Multi-Sensory-Devices/8x8-Wireless-Array/PCB Files/Ryuji_Controller/Resources/FPGA Dimensions.png

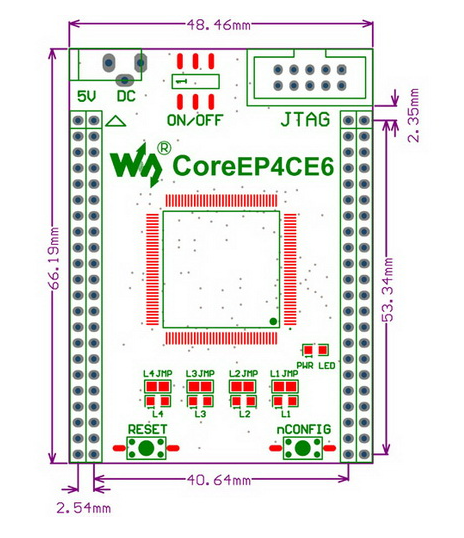
PCB Files/Ryuji_Controller/Resources/FPGA Dimensions.png
