Multi-Sensory-Devices/8x8-Wireless-Array/WiFi Code/first port to framework/README.md

# OpenMPD_Driver
OpenMPD is a low-level presentation engine allowing structured exploitation of any combination of MPD content (i.e., visual, tactile, audio) while dealing with the challenges specific to MPD content presentation.

For instance, our multi-rate runtime cycle allows us to combine very high computation rates for the sound-field (i.e., 10K sound-fields per second, for optimum acoustic control), with lower rates for control and rendering processes (i.e., hundreds of Hz, as typically used by rendering engines or tracking devices supporting interaction). Our low-level synchronization allows us to retain accurate interoperation among these processes, All of these enable novel capabilities, such as enabling colour projection onto high-speed particles or swept displays, as well as dexterous manipulations, such as in PoV content changing shape or precise combinations with other PoV paths. 

## OpenMPD Main Repository
[Main](https://github.com/RobertoMontano/OpenMPD)

## OpenMPD Libraries
[Libs](https://github.com/RobertoMontano/OpenMPD_Libs)

## OpenMPD Solver
[Solver](https://github.com/RobertoMontano/OpenMPD_Solvers)

## OpenMPD Installation Guide
[Setup](https://github.com/RobertoMontano/OpenMPD/blob/main/Docs/OpenMPD_FrameworkSetup.pdf)

## OpenMPD Framework Guide
[Guide](https://github.com/RobertoMontano/OpenMPD/blob/main/Docs/OpenMPD%20Tutorials_Guide.pdf)

## OpenMPD Examples Guide
[Examples](https://github.com/RobertoMontano/OpenMPD/blob/main/Docs/OpenMPD%20Tutorials_Examples.pdf)

## License
[MIT](https://choosealicense.com/licenses/mit/)
