Multi-Sensory-Devices/8x8-Wireless-Array/2D Drawings/ArrayBoardDimensions.png

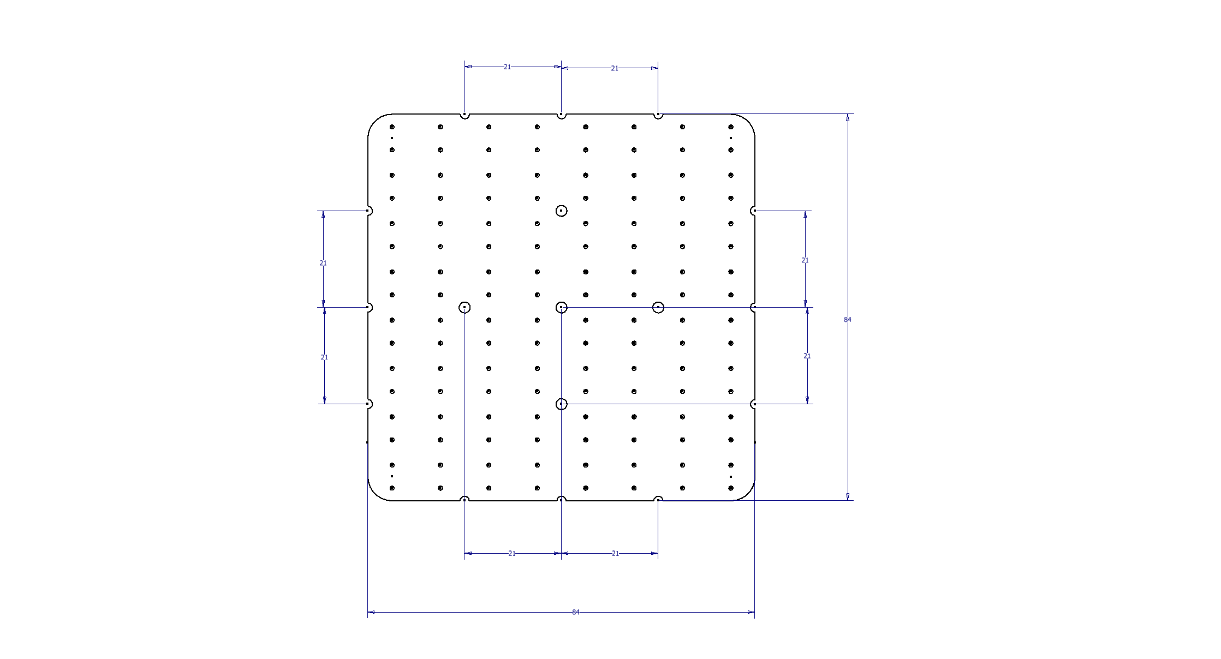
2D Drawings/ArrayBoardDimensions.png
