Multi-Sensory-Devices/8x8-Wireless-Array/2D Drawings/Controller_Ryuji.png

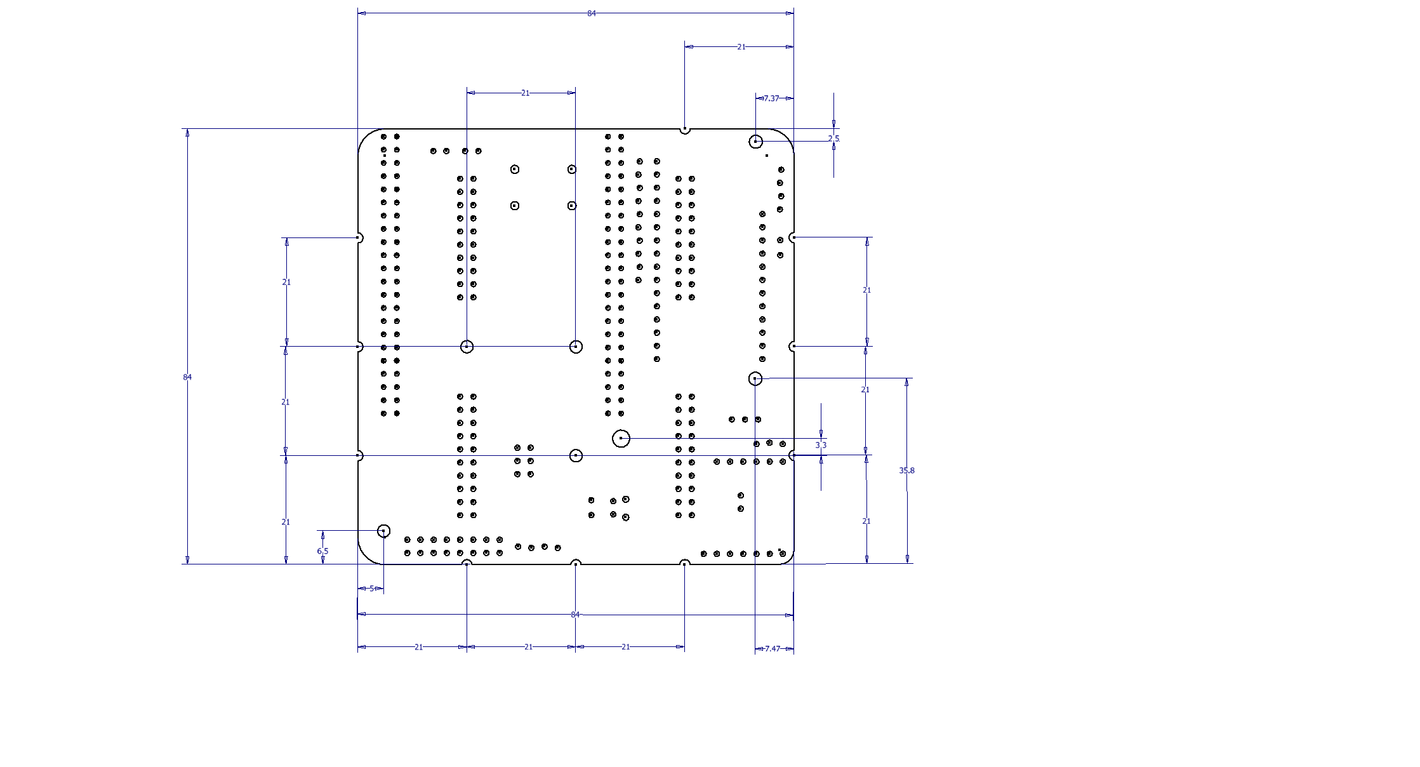
2D Drawings/Controller_Ryuji.png
