Multi-Sensory-Devices/8x8-Wireless-Array/PCB Files/Ryuji_Controller/Resources/circuitpython_Adafruit_Feather_nRF52840_Pinout.png

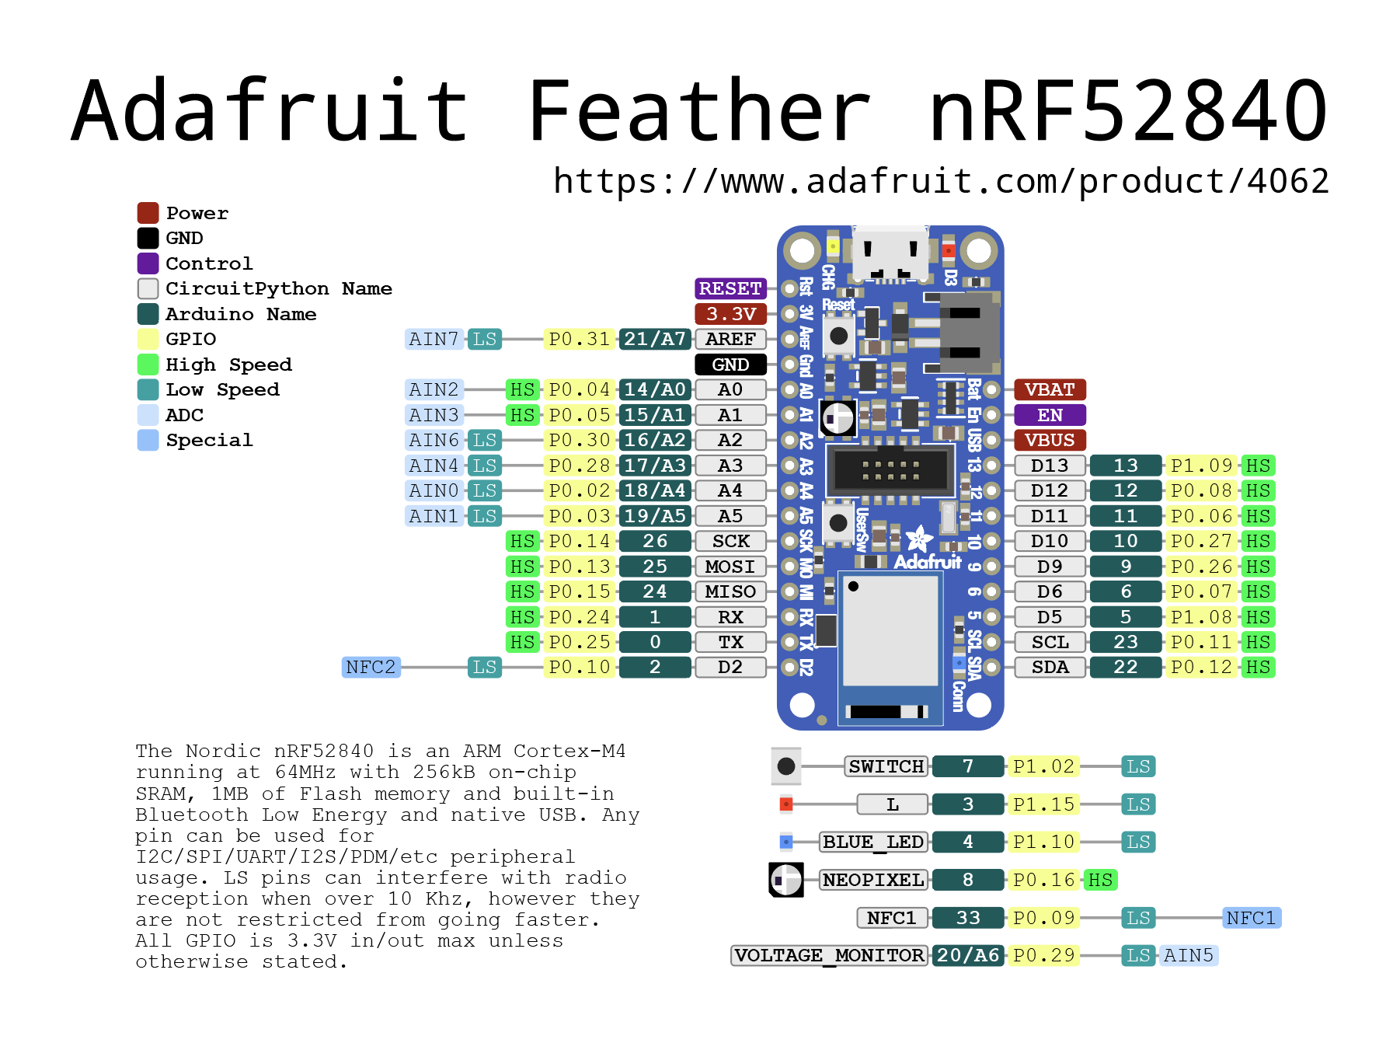
PCB Files/Ryuji_Controller/Resources/circuitpython_Adafruit_Feather_nRF52840_Pinout.png
