Multi-Sensory-Devices/8x8-Wireless-Array/2D Drawings/ArrayDimensions.dxf

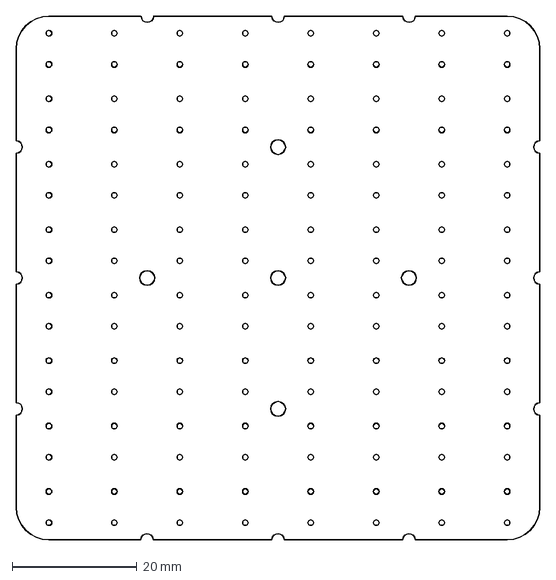
[picture p39: CAD file, 2023-06-09]
2D Drawings/ArrayDimensions.dxf
84.0 x 84.0 mm
