Multi-Sensory-Devices/8x8-Wireless-Array/3D Models/Jig/JigPrusa.3mf

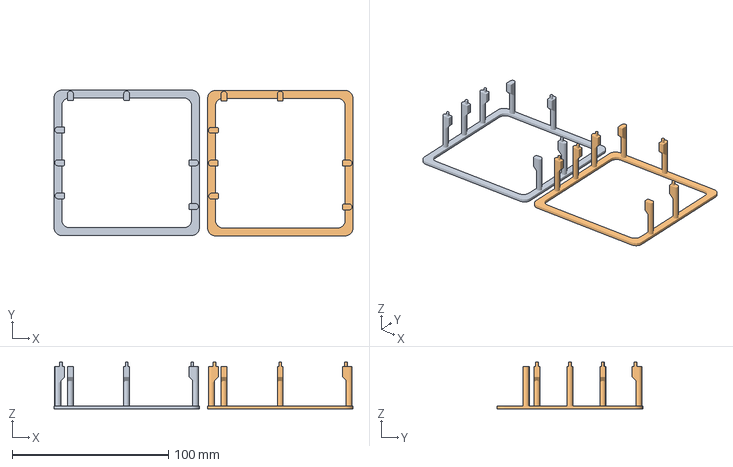
[picture p40: CAD file, 2023-06-09]
3D Models/Jig/JigPrusa.3mf
191.3 x 93.2 x 30.0 mm
