Multi-Sensory-Devices/8x8-Wireless-Array/PCB Files/Ryuji_8x8/Resources/B27c-2x10-BSAB1-G--3DModel-STEP-468060.STEP

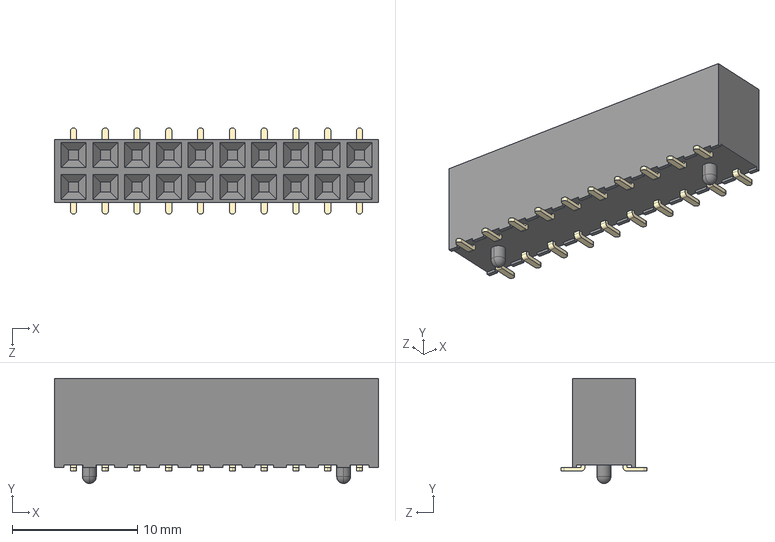
[picture p41: CAD file, 2023-06-09]
PCB Files/Ryuji_8x8/Resources/B27c-2x10-BSAB1-G--3DModel-STEP-468060.STEP
25.9 x 8.40 x 6.90 mm
