Multi-Sensory-Devices/8x8-Wireless-Array/2D Drawings/Controller Board Dimensions.dxf

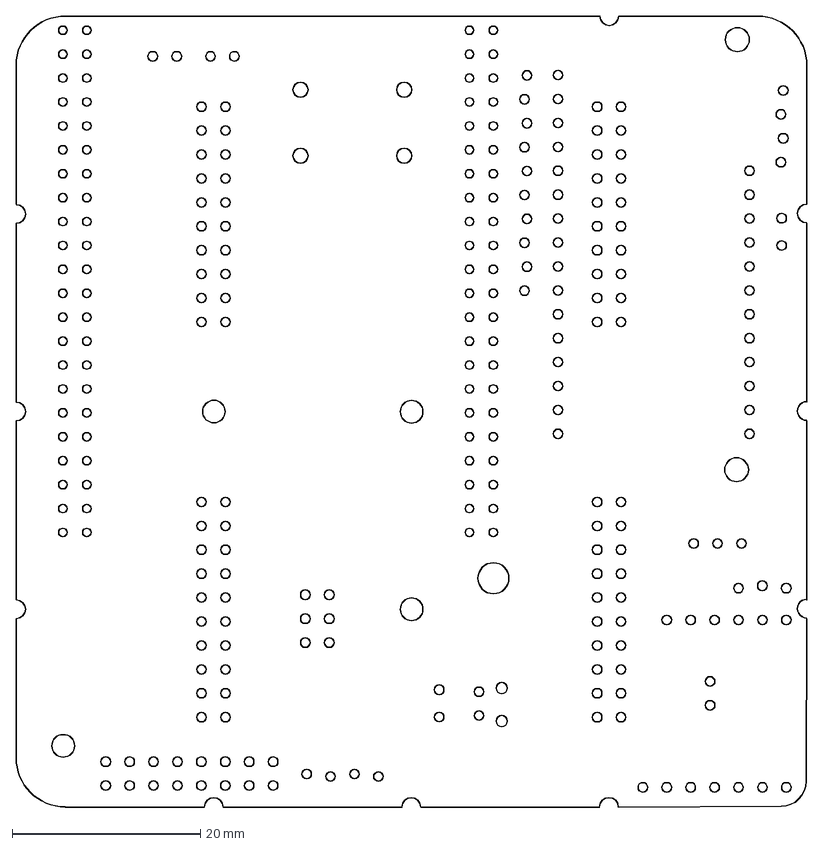
[picture p43: CAD file, 2023-06-09]
2D Drawings/Controller Board Dimensions.dxf
84.1 x 84.1 mm
