Multi-Sensory-Devices/8x8-Wireless-Array/3D Models/Jig/Jig.stp

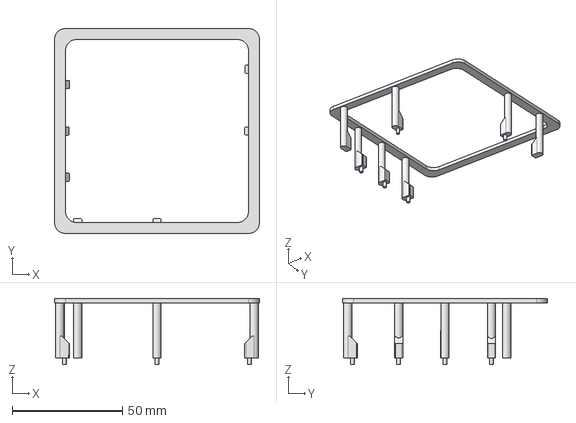
[picture p44: CAD file, 2023-06-09]
3D Models/Jig/Jig.stp
93.0 x 93.0 x 30.0 mm
