Multi-Sensory-Devices/8x8-Wireless-Array/PCB Files/Ryuji_8x8/Resources/TSSH-110-01-L-D.stp

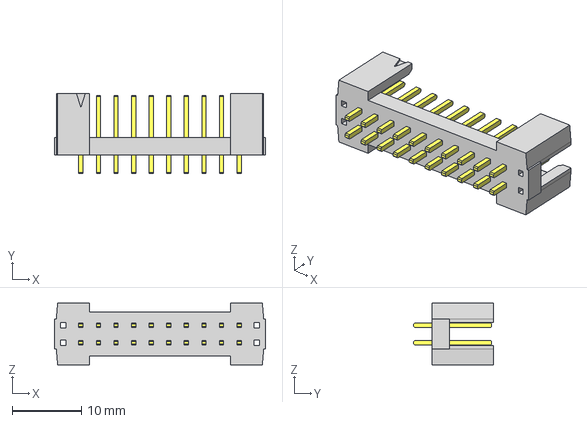
[picture p45: CAD file, 2023-06-09]
PCB Files/Ryuji_8x8/Resources/TSSH-110-01-L-D.stp
30.5 x 11.6 x 8.89 mm
T-1S6-10-01-D-
TSSH-110-01-D_header
