Multi-Sensory-Devices/8x8-Wireless-Array/PCB Files/Ryuji_Controller/Resources/PHT-103-01-S-S.stp

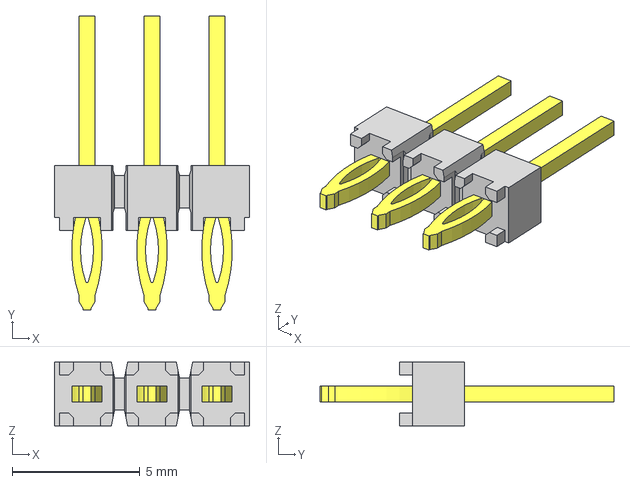
[picture p46: CAD file, 2023-06-09]
PCB Files/Ryuji_Controller/Resources/PHT-103-01-S-S.stp
7.62 x 11.5 x 2.49 mm
PHT-103-01-S_Pin
PHT-103-01-S_terminal
