Multi-Sensory-Devices/8x8-Wireless-Array/PCB Files/Ryuji_Controller/Resources/PHF-102-01-S-S.stp

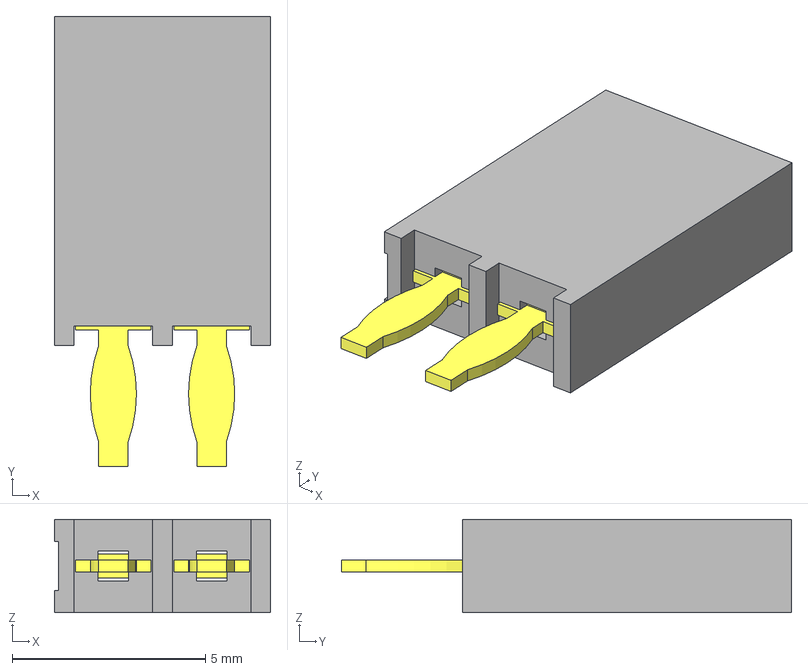
[picture p47: CAD file, 2023-06-09]
PCB Files/Ryuji_Controller/Resources/PHF-102-01-S-S.stp
5.59 x 11.6 x 2.41 mm
PHF102-01-S-S_pins
PHF102-01-S-S_terminal
