Multi-Sensory-Devices/8x8-Wireless-Array/PCB Files/Ryuji_8x8/Resources/SSW-110-22-G-D-VS.stp

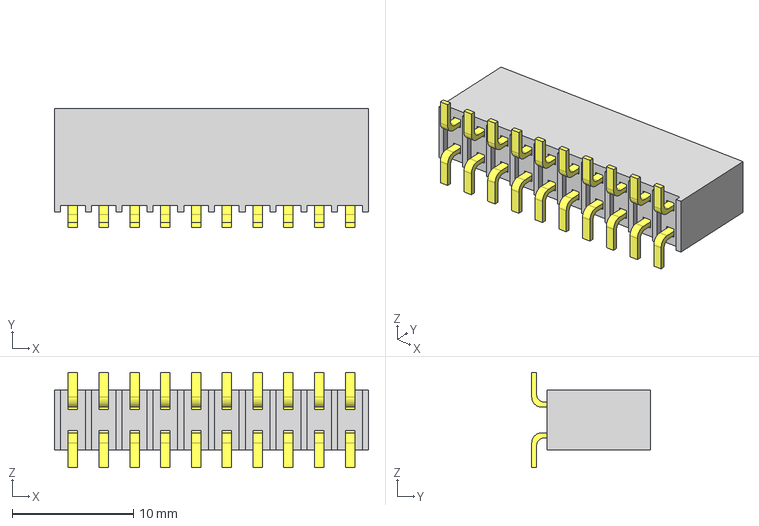
[picture p48: CAD file, 2023-06-09]
PCB Files/Ryuji_8x8/Resources/SSW-110-22-G-D-VS.stp
25.9 x 9.78 x 7.87 mm
P2SSW-110-22-G-D-VS
T1SSW-110-22-G-D-VS
