Multi-Sensory-Devices/8x8-Wireless-Array/PCB Files/Ryuji_Controller/Resources/PHF-116-01-S-S.stp

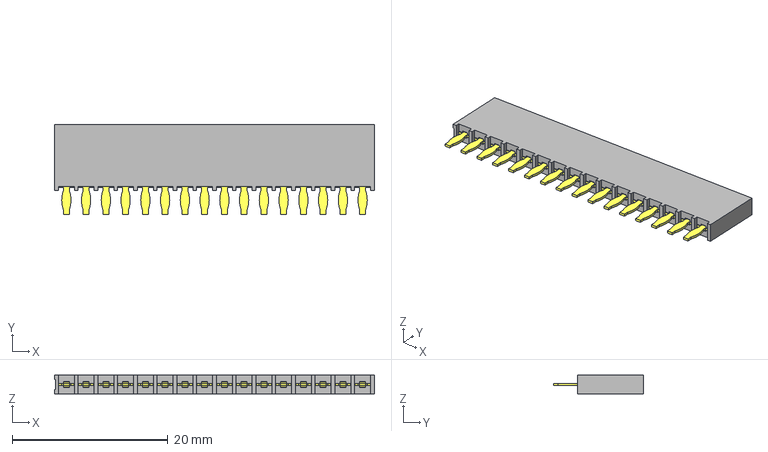
[picture p49: CAD file, 2023-06-09]
PCB Files/Ryuji_Controller/Resources/PHF-116-01-S-S.stp
41.1 x 11.6 x 2.41 mm
PHF116-01-S-S_pins
PHF116-01-S-S_terminal
