Multi-Sensory-Devices/8x8-Wireless-Array/PCB Files/Ryuji_Controller/Resources/PHF-104-01-S-S.stp

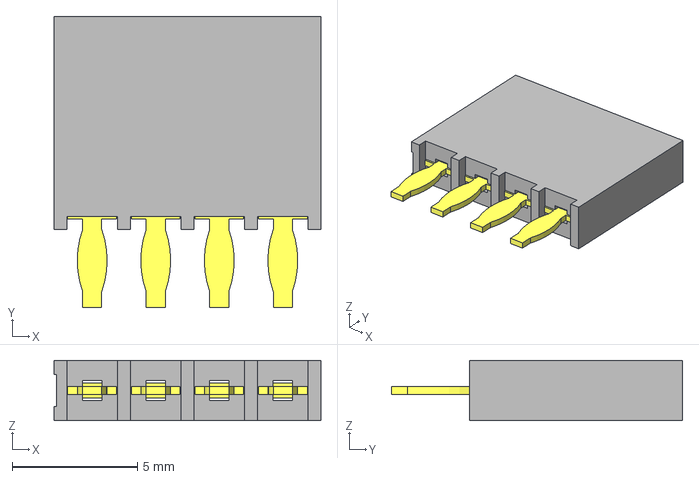
[picture p50: CAD file, 2023-06-09]
PCB Files/Ryuji_Controller/Resources/PHF-104-01-S-S.stp
10.7 x 11.6 x 2.41 mm
PHF104-01-S-S_pins
PHF104-01-S-S_terminal
