Multi-Sensory-Devices/8x8-Wireless-Array/PCB Files/Ryuji_Controller/Resources/PHF-106-01-S-S.stp

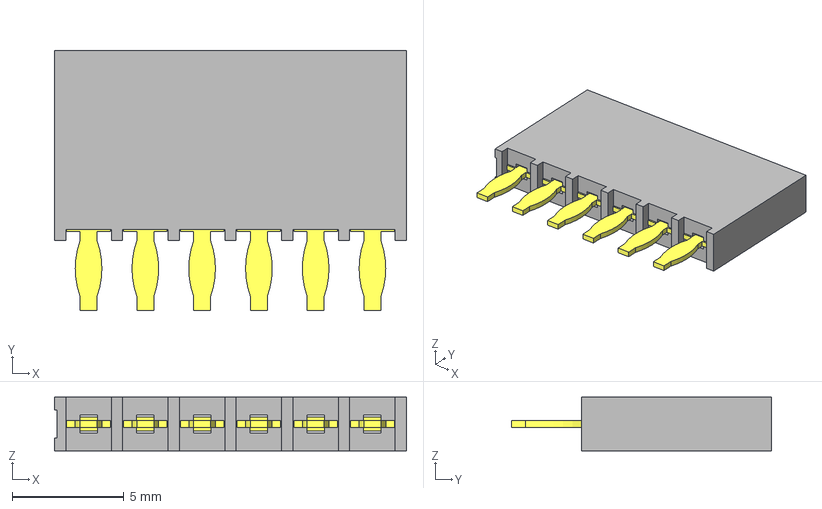
[picture p51: CAD file, 2023-06-09]
PCB Files/Ryuji_Controller/Resources/PHF-106-01-S-S.stp
15.7 x 11.6 x 2.41 mm
PHF106-01-S-S_pins
PHF106-01-S-S_terminal
