Multi-Sensory-Devices/8x8-Wireless-Array/PCB Files/Ryuji_Controller/Resources/PHT-104-01-S-S.stp

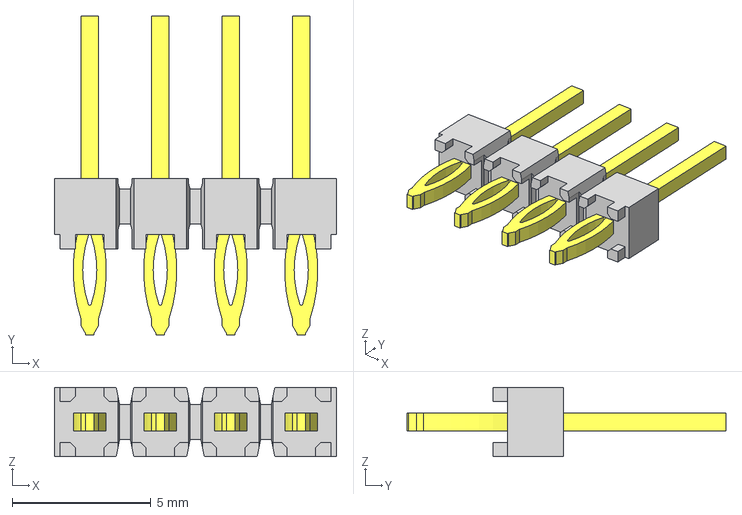
[picture p52: CAD file, 2023-06-09]
PCB Files/Ryuji_Controller/Resources/PHT-104-01-S-S.stp
10.2 x 11.5 x 2.49 mm
PHT-104-01-S_Pin
PHT-104-01-S_terminal
