Multi-Sensory-Devices/8x8-Wireless-Array/PCB Files/Ryuji_Controller/Resources/PHF-103-01-S-S.stp

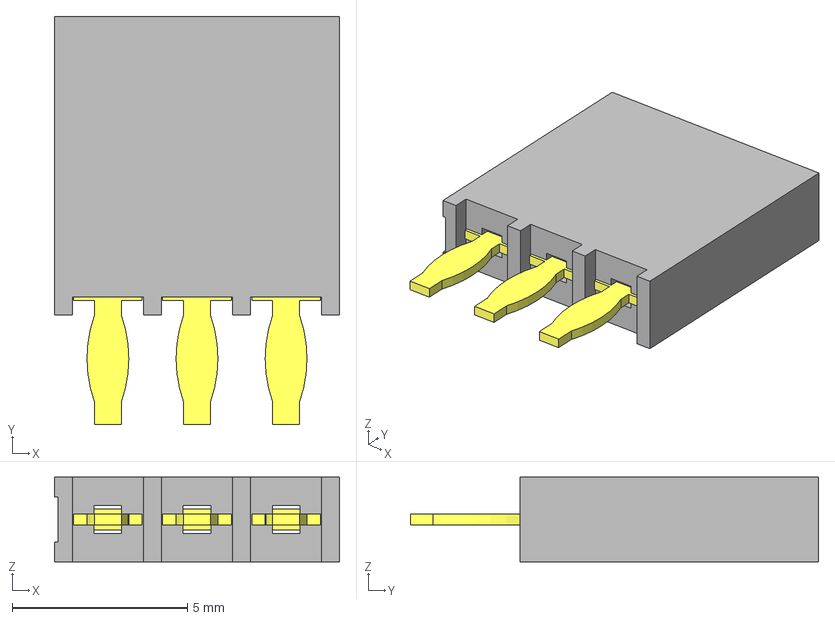
[picture p53: CAD file, 2023-06-09]
PCB Files/Ryuji_Controller/Resources/PHF-103-01-S-S.stp
8.13 x 11.6 x 2.41 mm
PHF103-01-S-S_pins
PHF103-01-S-S_terminal
