Multi-Sensory-Devices/8x8-Wireless-Array/PCB Files/Ryuji_Controller/Resources/PHF-112-01-S-S.stp

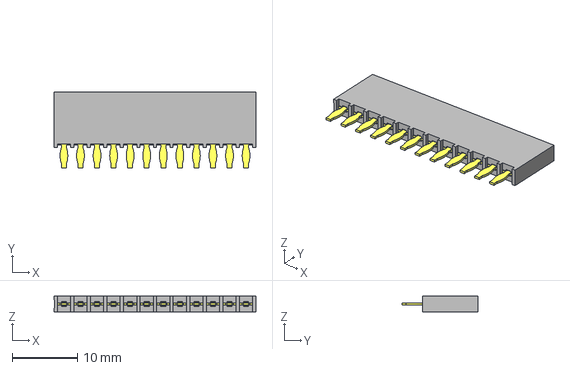
[picture p54: CAD file, 2023-06-09]
PCB Files/Ryuji_Controller/Resources/PHF-112-01-S-S.stp
31.0 x 11.6 x 2.41 mm
PHF112-01-S-S_pins
PHF112-01-S-S_terminal
