Multi-Sensory-Devices/8x8-Wireless-Array/PCB Files/Ryuji_Controller/Resources/PHF-107-01-S-S.stp

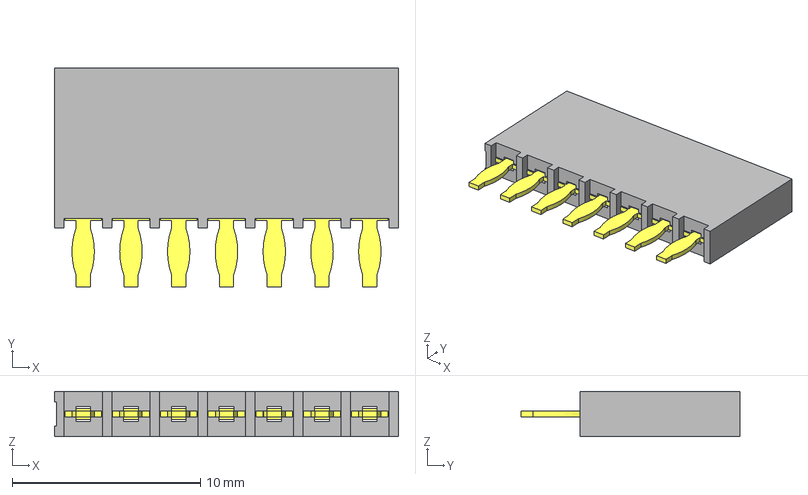
[picture p55: CAD file, 2023-06-09]
PCB Files/Ryuji_Controller/Resources/PHF-107-01-S-S.stp
18.3 x 11.6 x 2.41 mm
PHF107-01-S-S_pins
PHF107-01-S-S_terminal
