Multi-Sensory-Devices/8x8-Wireless-Array/PCB Files/Ryuji_Controller/Resources/7-534206-2.stp

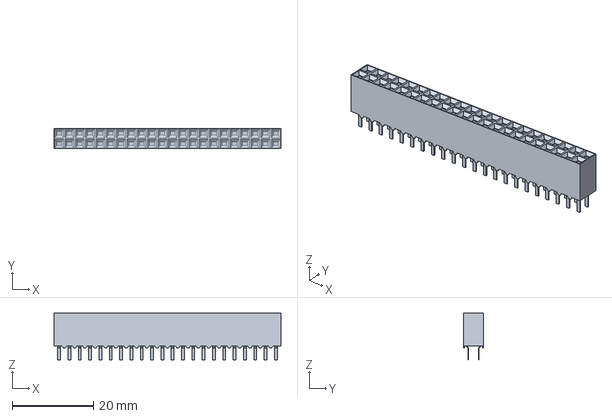
[picture p57: CAD file, 2023-06-09]
PCB Files/Ryuji_Controller/Resources/7-534206-2.stp
55.9 x 5.03 x 11.6 mm
