Multi-Sensory-Devices/8x8-Wireless-Array/PCB Files/Ryuji_Controller/Resources/TSW-102-09-G-S-RA.stp

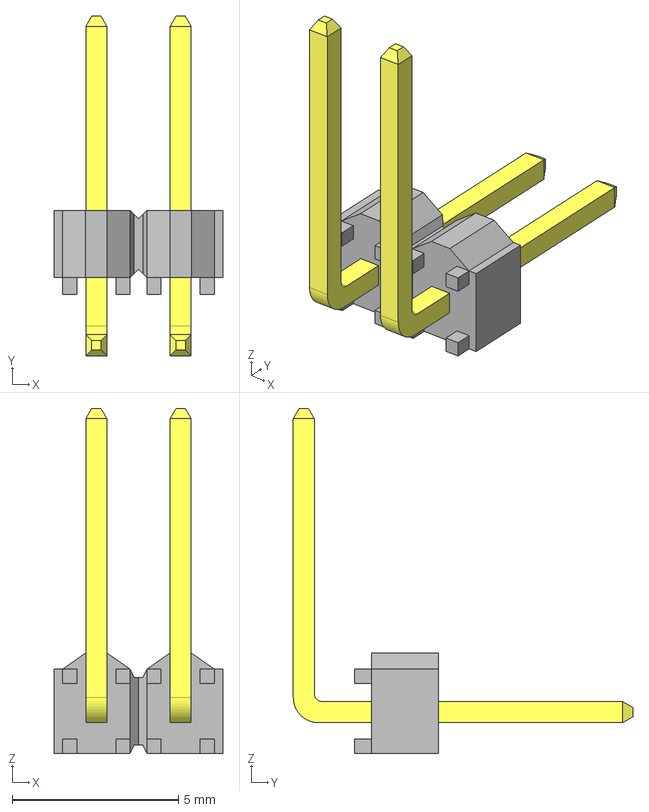
[picture p58: CAD file, 2023-06-09]
PCB Files/Ryuji_Controller/Resources/TSW-102-09-G-S-RA.stp
5.08 x 10.2 x 10.4 mm
T-1S6-09-TSW-1-09-2-RA-S
TSW-102-09-G-S-RA_body
