Multi-Sensory-Devices/8x8-Wireless-Array/(list of files, cad)

Other CAD files:
PCB Files/Ryuji_8x8/Resources/3405 Adafruit HUZZAH32 ESP32 Feather.step
3D Models/Jig/Jig.ipt
3D Models/Jig/OldVersions/Jig.0002.ipt
