Multi-Sensory-Devices/8x8-Wireless-Array/(list of files, drawings)

Other design files:
PCB Files/Ryuji_8x8/AmplifyEmit.SchDoc
PCB Files/Ryuji_8x8/ArrayBoard.PcbDoc
PCB Files/Ryuji_8x8/ArrayBoardTop.SchDoc
PCB Files/Ryuji_8x8/Headers.SchDoc
PCB Files/Ryuji_8x8/Resources/Imported Adafruit HUZZAH32 ESP32 Feather.PrjPcb/Adafruit HUZZAH32 ESP32 Feather.PrjPcb
PCB Files/Ryuji_8x8/Resources/Imported Adafruit HUZZAH32 ESP32 Feather.PrjPcb/Adafruit HUZZAH32 ESP32 Feather.SchDoc
PCB Files/Ryuji_8x8/Resources/Imported Adafruit HUZZAH32 ESP32 Feather.PrjPcb/History/Adafruit HUZZAH32 ESP32 Feather.~(3).PcbDoc
PCB Files/Ryuji_8x8/Resources/SSW-110-22-G-D-VS/SAMTEC_SSW-110-22-G-D-VS.PcbLib
PCB Files/Ryuji_8x8/Resources/SSW-110-22-G-D-VS/SSW-110-22-G-D-VS.SchLib
PCB Files/Ryuji_8x8/Resources/TSSH-110-01-L-D/SAMTEC_TSSH-110-01-L-D.PcbLib
PCB Files/Ryuji_8x8/Resources/TSSH-110-01-L-D/TSSH-110-01-L-D.SchLib
PCB Files/Ryuji_8x8/Ryuji_8x8.PrjPcb
PCB Files/Ryuji_Controller/Controller_Ryuji.PcbDoc
PCB Files/Ryuji_Controller/Headers_Controller.SchDoc
PCB Files/Ryuji_Controller/History/Controller_Ryuji.~(131).PcbDoc
PCB Files/Ryuji_Controller/History/Controller_Ryuji.~(133).PcbDoc
PCB Files/Ryuji_Controller/Resources/CoreEP4CE6.PcbDoc
PCB Files/Ryuji_Controller/Resources/Imported (1) Adafruit nRF52840 Bluefruit Feather Express Rev D.PrjPcb/Adafruit nRF52840 Bluefruit Feather Express Rev D.PrjPcb
PCB Files/Ryuji_Controller/Resources/Imported (1) SparkFun_STUSB4500_USB-PD.PrjPcb/SparkFun_STUSB4500_USB-PD.PcbDoc
PCB Files/Ryuji_Controller/Resources/Imported (1) SparkFun_STUSB4500_USB-PD.PrjPcb/SparkFun_STUSB4500_USB-PD.PrjPcb
PCB Files/Ryuji_Controller/Resources/Imported (1) SparkFun_STUSB4500_USB-PD.PrjPcb/SparkFun_STUSB4500_USB-PD.SchDoc
PCB Files/Ryuji_Controller/Resources/Imported Adafruit nRF52840 Bluefruit Feather Express Rev D.PrjPcb/Adafruit nRF52840 Bluefruit Feather Express Rev D.PrjPcb
PCB Files/Ryuji_Controller/Resources/Imported Adafruit nRF52840 Bluefruit Feather Express Rev D.PrjPcb/Adafruit nRF52840 Bluefruit Feather Express Rev D_1.SchDoc
PCB Files/Ryuji_Controller/Ryuji_Controller.PrjPcb
PCB Files/V1 PC Files/Array V1.PcbDoc
PCB Files/V1 PC Files/Controller V1.PcbDoc
