Multi-Sensory-Devices/8x8-Wireless-Array/PCB Files/Ryuji_8x8/Resources/Adafruit HUZZAH32 ESP32 Feather.brd

## EAGLE design PCB Files/Ryuji_8x8/Resources/Adafruit HUZZAH32 ESP32 Feather.brd (2023-06-09)


Parts:
C1, C2: 10uF; 0805-NO
C3, C6, C8: 10µF; 0805-NO
C4, C7: 1uF; 0603-NO
CHG: ORANGE; CHIPLED_0805_NOOUTLINE
D3: RED; CHIPLED_0805_NOOUTLINE
D4: MBR120; SOD-123
IC1: CP2104; QFN24_4MM_SMSC
JP1: HEADER-1X16_MIN; 1X16_ROUND_MIN
JP3: HEADER-1X12_MIN; 1X12_ROUND_MIN
Q1, Q2: mmbt2222; SOT23-3
Q3: DMG3415U; SOT23-R
R1, R3, R7, R12: 100K; 0603-NO
R2, R10: 1K; 0603-NO
R4: 4.7K; 0603-NO
R13: 10K; RESPACK_4X0603
SW2: KMR2; BTN_KMR2_4.6X2.8
U2: AP2112-3.3; SOT23-5
U3: MCP73831T-2ACI/OT; SOT23-5
U$31, U$32: MOUNTINGHOLE2.5; MOUNTINGHOLE_2.5_PLATED
U$34, U$35: FIDUCIAL_1MM
X1: JSTPH; JSTPH2
X2: ESP32_WROOM32_SKINNY; WROOM32_SKINNY
X4: 20329; 4UCONN_20329_V2

Connections:
3.3V: C1.1, C2.1, C7.1, C8.1, IC1.5 (VIO), IC1.6 (VDD), IC1.7 (REGIN), JP1.15, R13.3 (1), U2.5 (OUT), X2.2 (3.3V)
A0_DAC2: JP1.12, X2.11 (IO26/DAC2/A2_9)
A1_DAC1: JP1.11, X2.10 (IO25/DAC1/A2_8)
A2_I34: JP1.10, X2.6 (I34/A1_6)
A3_I39: JP1.9, X2.5 (IO39/SEN_VN/A1_3)
A4_IO36: JP1.8, X2.4 (IO36/SEN_VP/A1_0)
A5_IO4: JP1.7, X2.26 (IO4/A2_0)
A13_I35: R1.1, R3.2, X2.7 (I35/A1_7)
DTR: IC1.23 (DTR), Q2.2 (E), R13.4 (1)
EN: JP3.2, R7.1, U2.3 (EN)
GND: C1.2, C2.2, C3.2, C4.2, C6.2, C7.2, C8.2, D3.C, IC1.2 (GND), IC1.THERM (TP), JP1.13, R3.1, R4.1, R12.1, SW2.A, SW2.A' (P1), U2.2 (GND), U3.2 (VSS), X1.1, X2.1 (GND), X2.15 (GND), X2.38 (GND), X2.P$1 (GND), X4.BASE@1 (GND), X4.BASE@2 (GND), X4.GND, X4.SPRT@1 (GND), X4.SPRT@2 (GND), X4.SPRT@3 (GND), X4.SPRT@4 (GND)
GPIO0: Q2.3 (C), X2.25 (IO0/A2_1)
GPIO2: X2.24 (IO2/A2_2)
IO12_A11: JP3.5, X2.14 (IO12/A2_5)
IO13_A12: JP3.4, R10.1, X2.16 (IO13/A2_4)
IO14_A6: JP3.10, X2.13 (IO14/A2_6)
IO15_A8: JP3.8, X2.23 (IO15/A2_3)
IO16: JP1.3, X2.27 (IO16)
IO17: JP1.2, X2.28 (IO17)
IO21: JP1.1, X2.33 (IO21)
IO27_A10: JP3.6, X2.12 (IO27/A2_7)
IO32_A7: JP3.9, X2.8 (IO32/A1_4/X32P)
IO33_A9: JP3.7, X2.9 (IO33/A1_5/X32N)
MISO: JP1.4, X2.31 (IO19)
MOSI: JP1.5, X2.30 (IO18)
unnamed: CHG.C, R2.1
unnamed: IC1.3 (D+), X4.D+
unnamed: R2.2, U3.1 (STAT)
unnamed: R4.2, U3.5 (PROG)
unnamed: D3.A, R10.2
unnamed: IC1.4 (D-), X4.D-
unnamed: C6.1, D4.C, Q3.2 (S), R7.2, U2.1 (IN)
unnamed: Q1.1 (B), R13.5 (2)
unnamed: Q2.1 (B), R13.2 (1)
RESET: C4.1, JP1.16, Q1.3 (C), R13.6 (2), SW2.B (S), SW2.B' (S1), X2.3 (EN)
RTS: IC1.19 (RTS), Q1.2 (E), R13.7 (2)
RXD0: IC1.21 (TXD), X2.34 (RXD0)
SCK: JP1.6, X2.29 (IO5)
SCL: JP3.11, X2.36 (IO22)
SDA: JP3.12, X2.37 (IO23)
TXD0: IC1.20 (RXD), X2.35 (TXD0)
VBAT: C3.1, JP3.1, Q3.3 (D), R1.2, U3.3 (VBAT), X1.2
VBUS: CHG.A, D4.A, IC1.8 (VBUS), JP3.3, Q3.1 (G), R12.2, U3.4 (VDD), X4.VBUS

Notes on the sheet:
POWER AND FILTERING
RESET
10K = 100mA
5.0K = 200mA
2.0K = 500mA
1.0K = 1000mA
USB TO SERIAL CONVERTER
LIPO CHARGING
LED
ESP3212 MODULE + AUTORESET
NC: IO0,IO2 VBAT SENSE: IO35 LED: IO13



Board: 2 copper layers, 50.8 x 22.9 mm, 40 parts (4 on the bottom side), 42 nets.

Other parts of the board:
U$7: ADAFRUIT_5MM
U$9: FEATHERLOGO_MED
U$13: PCBFEAT-REV-040
U$14: ADAFRUIT_2.5MM
U$15: ADAFRUIT_3.5MM
U$43: HUZZAH32
