Multi-Sensory-Devices/8x8-Wireless-Array/Firmware/MCU/PinBluetoothClassicV2/PinBluetoothClassicV2.ino

//This example code is in the Public Domain (or CC0 licensed, at your option.)
//By Evandro Copercini - 2018
//
//This example creates a bridge between Serial and Classical Bluetooth (SPP)
//and also demonstrate that SerialBT have the same functionalities of a normal Serial

#include "BluetoothSerial.h"

//#define USE_PIN // Uncomment this to use PIN during pairing. The pin is specified on the line below
//const char *pin = "1234"; // Change this to more secure PIN.

String device_name = "RyujiClassic_1";

#if !defined(CONFIG_BT_ENABLED) || !defined(CONFIG_BLUEDROID_ENABLED)
#error Bluetooth is not enabled! Please run `make menuconfig` to and enable it
#endif

#if !defined(CONFIG_BT_SPP_ENABLED)
#error Serial Bluetooth not available or not enabled. It is only available for the ESP32 chip.
#endif

BluetoothSerial SerialBT;

void setup() {
  Serial.begin(2000000);
  Serial1.begin(2000000);
  SerialBT.begin(device_name); //Bluetooth device name
  Serial.printf("The device with name \"%s\" is started.\nNow you can pair it with Bluetooth!\n", device_name.c_str());
  //Serial.printf("The device with name \"%s\" and MAC address %s is started.\nNow you can pair it with Bluetooth!\n", device_name.c_str(), SerialBT.getMacString()); // Use this after the MAC method is implemented
//#ifdef USE_PIN
//  SerialBT.setPin(pin);
//  Serial.println("Using PIN");
//#endif

}

void loop() {
  if (Serial.available())
  {
    SerialBT.write(Serial.read());
  }
  if (SerialBT.available())
  {
    char s = SerialBT.read();
    Serial.write(s);
    Serial1.write(s);
  }
}
