Multi-Sensory-Devices/8x8-Wireless-Array/(commit log)

2023-06-09 Initial Upload
    Completed files,
    TODO: Rename project from Ryuji to intended name
    [3405 Adafruit HUZZAH32 ESP32 Feather.step, 4062-nRF52830-Feather.step, 7-534206-2.stp, Adafruit HUZZAH32 ESP32 Feather.PrjPcb, Adafruit HUZZAH32 ESP32 Feather.SchDoc, Adafruit HUZZAH32 ESP32 Feather.brd, Adafruit HUZZAH32 ESP32 Feather.sch, Adafruit HUZZAH32 ESP32 Feather.~(3).PcbDoc]
2023-07-27 initial commit of wifi code containing old discarded code, and working server and clients
    windows client
    esp32 client
    windows server
2023-07-27 Updates to PCBs
    [Controller_Ryuji.GBL, Controller_Ryuji.GBO, Controller_Ryuji.GBP, Controller_Ryuji.GBS, Controller_Ryuji.GKO, Controller_Ryuji.GTL, Controller_Ryuji.GTO, Controller_Ryuji.GTP]
