Multi-Sensory-Devices/8x8-Wireless-Array/(notices)

Notices in the files:
PCB Files/Ryuji_8x8/Resources/SSW-110-22-G-D-VS.stp:
author */ ('License CC BY-ND 4.0'),
parts and their libraries:
microbuilder: This work is placed in the public domain, and may be freely used for commercial and non-commercial work with the following conditions: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
SparkFun: Licensing: CC v3.0 Share-Alike You are welcome to use this library for commercial purposes.
